GustavoSMafra/LM35_Arduino/Termômetro LM35/Imagens/Protótipo desenvolvido.jpg

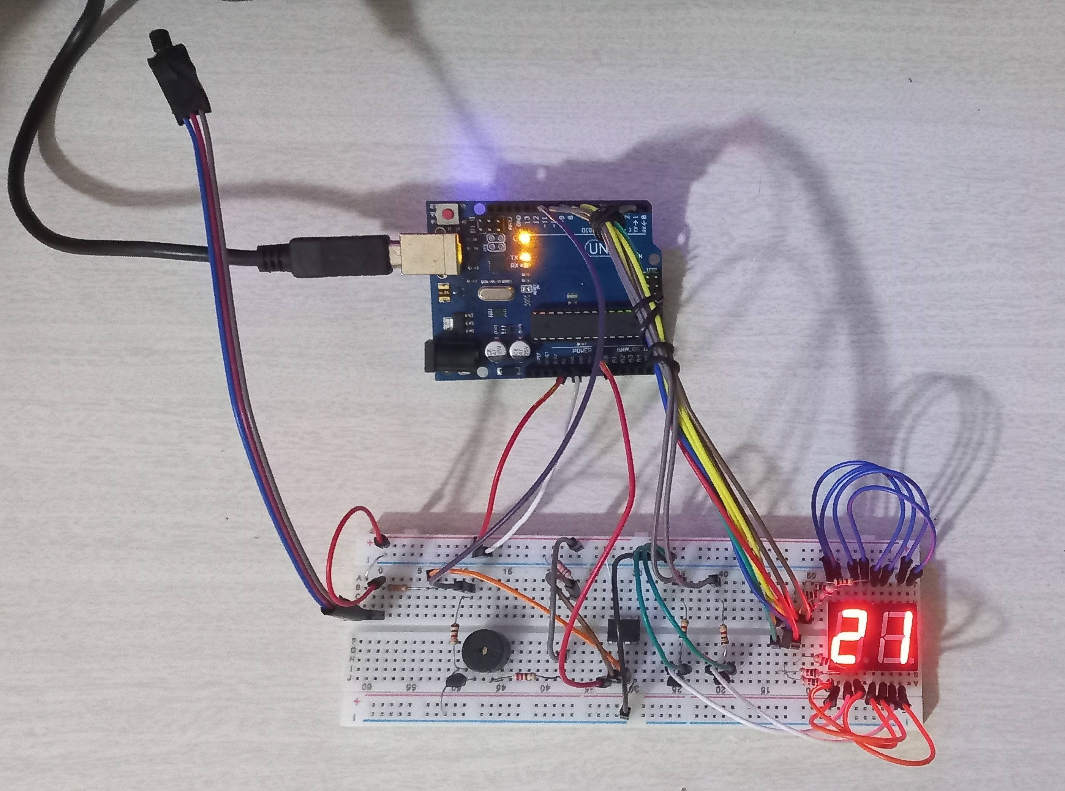
Termômetro LM35/Imagens/Protótipo desenvolvido.jpg
