GustavoSMafra/LM35_Arduino/(list of files, drawings)

Other design files:
Termômetro LM35/LM35_Esquemático.pdsprj
Termômetro LM35/LM35_SIM.pdsprj
